BareMetal6502/BuzzKill/documentation/README.md

# User Documentation

* [Hardware Guide](./BuzzKill_hardware_guide.pdf) -- Quick guide for hardware connections. Contains information on powering the board, interfacing with other devices, speaker requirements, and mounting options.

* [User Guide](./BuzzKill_user_guide.pdf) -- Detailed guide to operations. Contains information on communications, command protocol, and instructions for controlling all operations of the board.
