BareMetal6502/BuzzKill/firmware/src/README.md

# Firmware Source Files

You can use these files to assemble your own binary, modifying as you see fit.
