BareMetal6502/BuzzKill/hardware/BuzzKill_image_bot.png

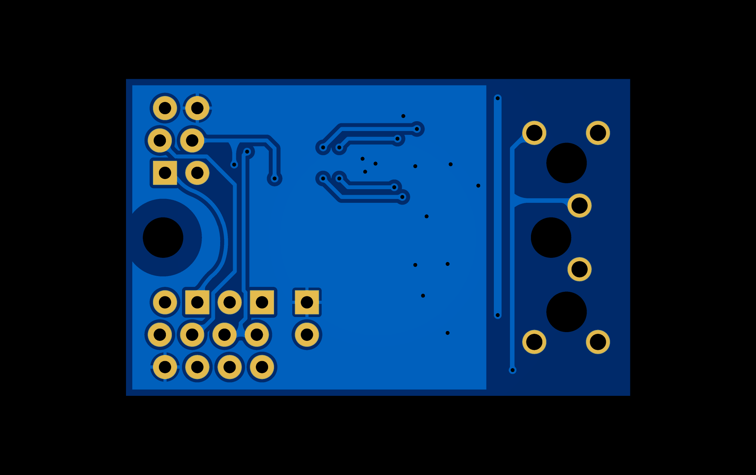
hardware/BuzzKill_image_bot.png
