BareMetal6502/BuzzKill/hardware/BuzzKill_image_top.png

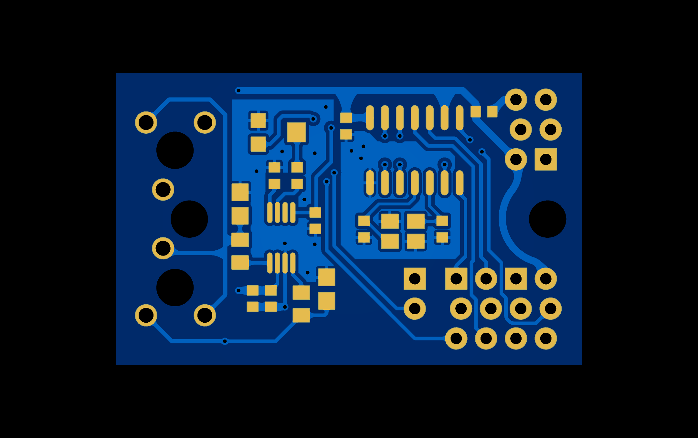
hardware/BuzzKill_image_top.png
