BareMetal6502/BuzzKill/hardware/BuzzKill_schematic.png

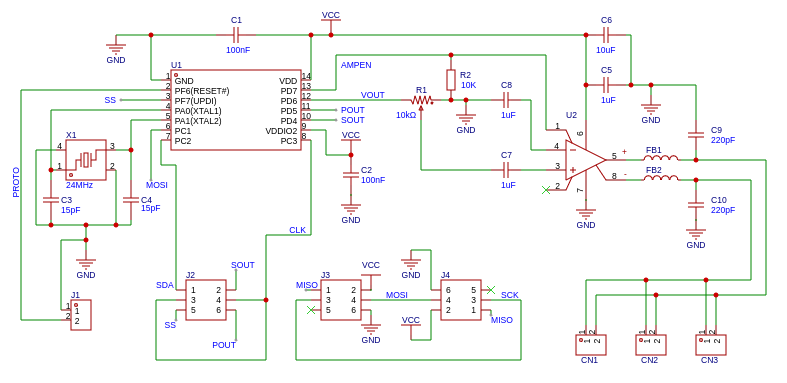
hardware/BuzzKill_schematic.png
