BareMetal6502/BuzzKill/hardware/BuzzKill_traces_bot.png

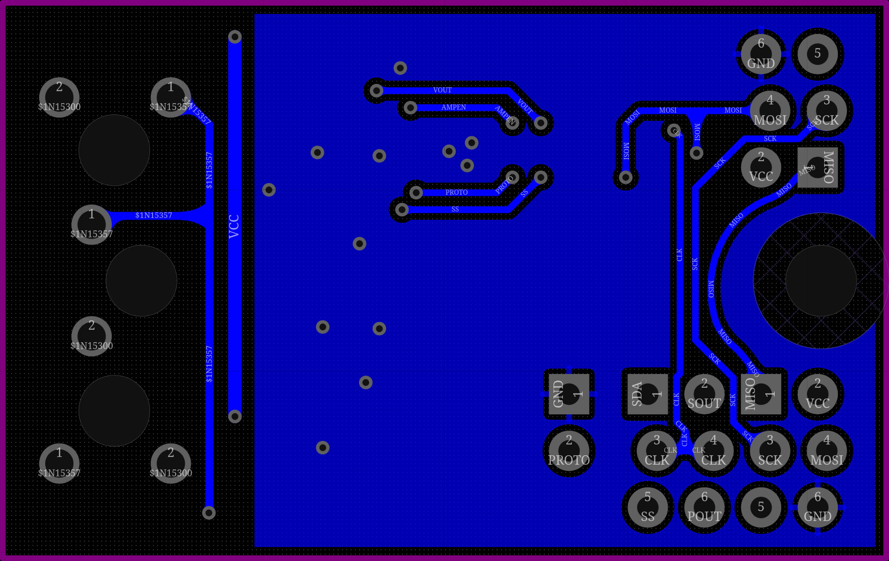
hardware/BuzzKill_traces_bot.png
