BareMetal6502/BuzzKill/hardware/BuzzKill_traces_top.png

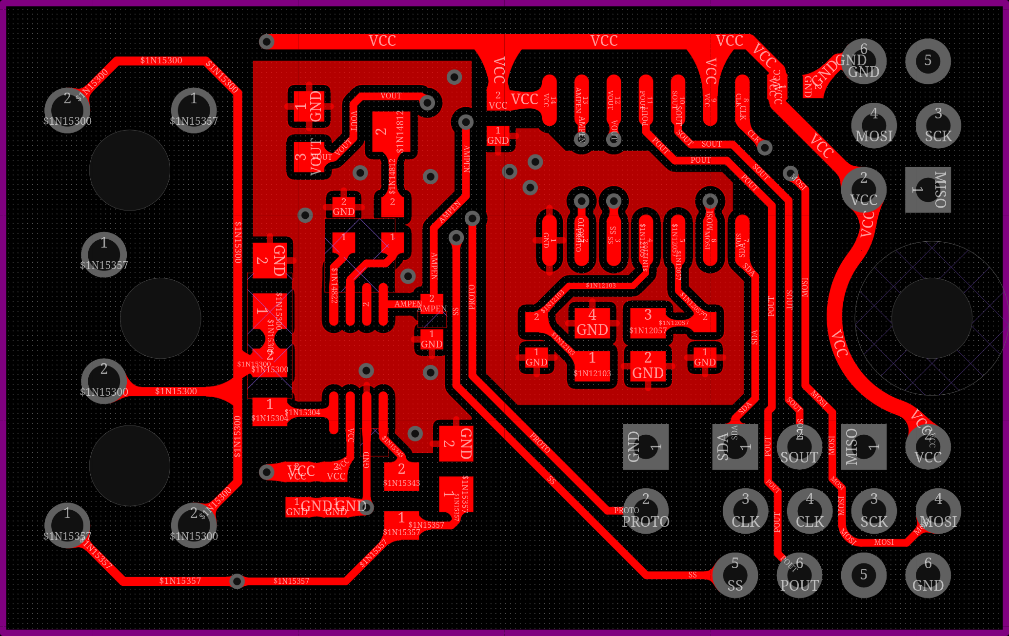
hardware/BuzzKill_traces_top.png
