BareMetal6502/BuzzKill/hardware/BuzzKill_component_layout.png

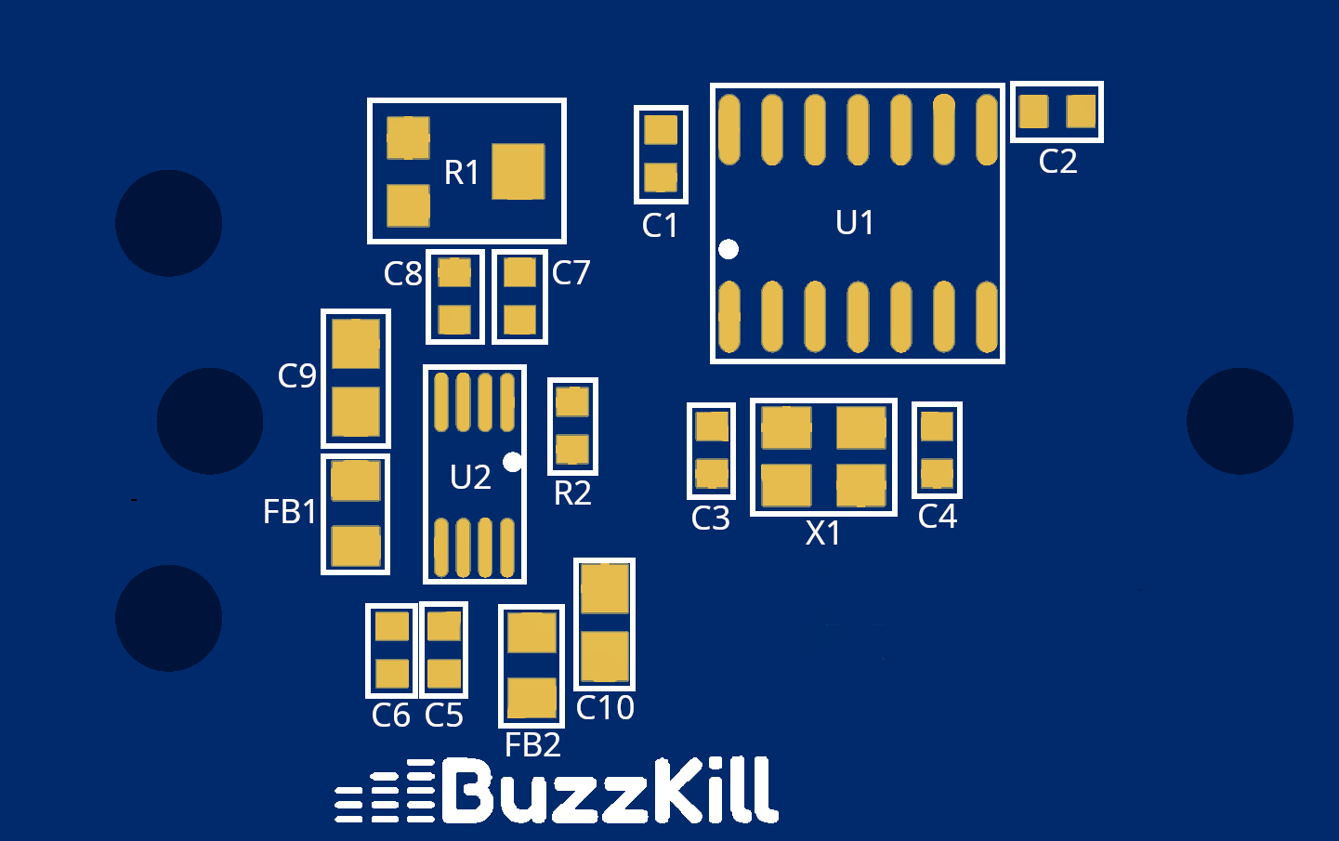
hardware/BuzzKill_component_layout.png
